karimn14/firware-reflow-oven-bluepill/heater_char/perbandingan grafik.png

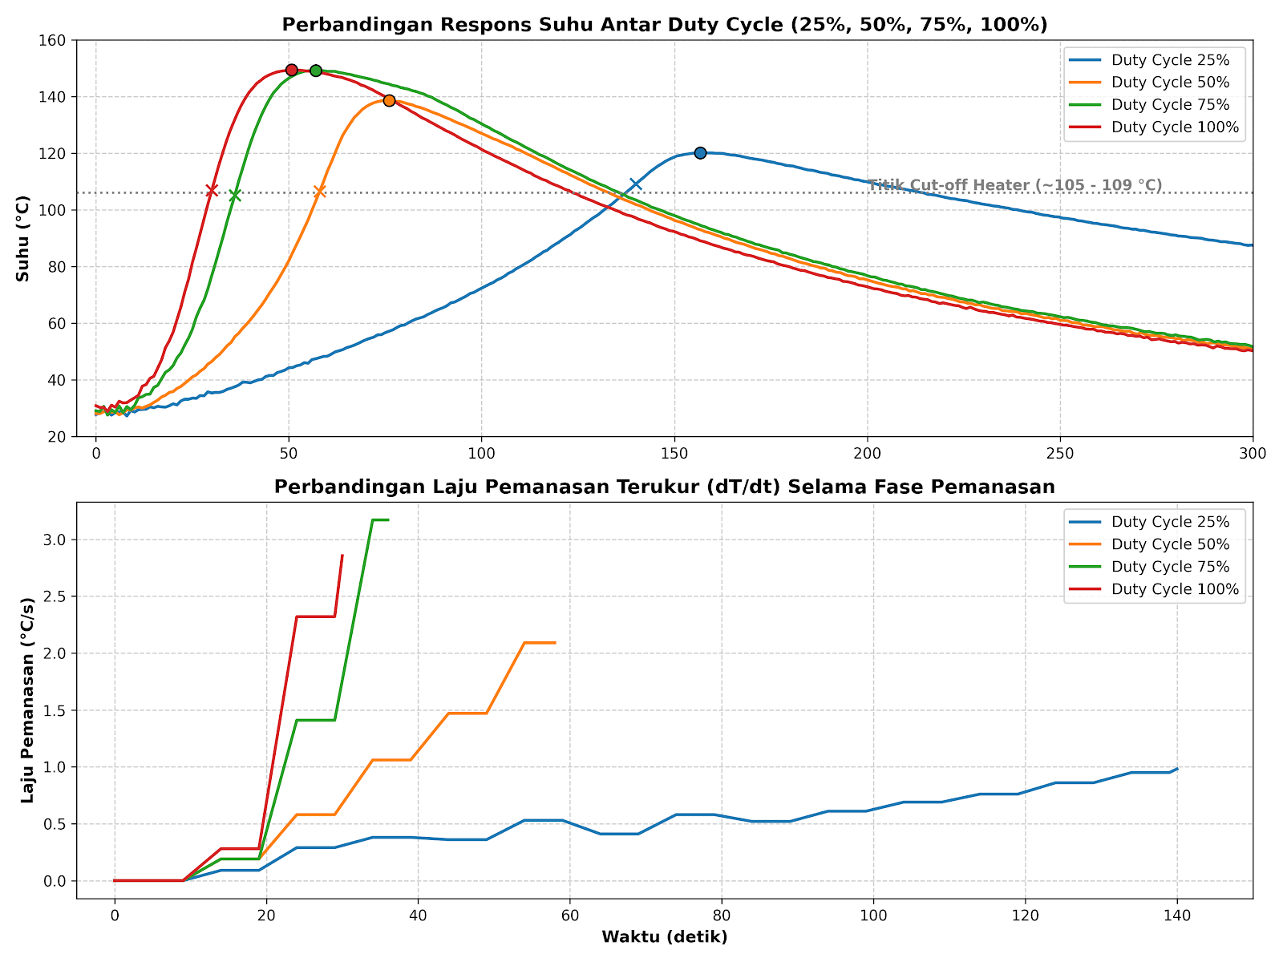
heater_char/perbandingan grafik.png
