karimn14/firware-reflow-oven-bluepill/heater_char/heater_individual_dc_characterization.png

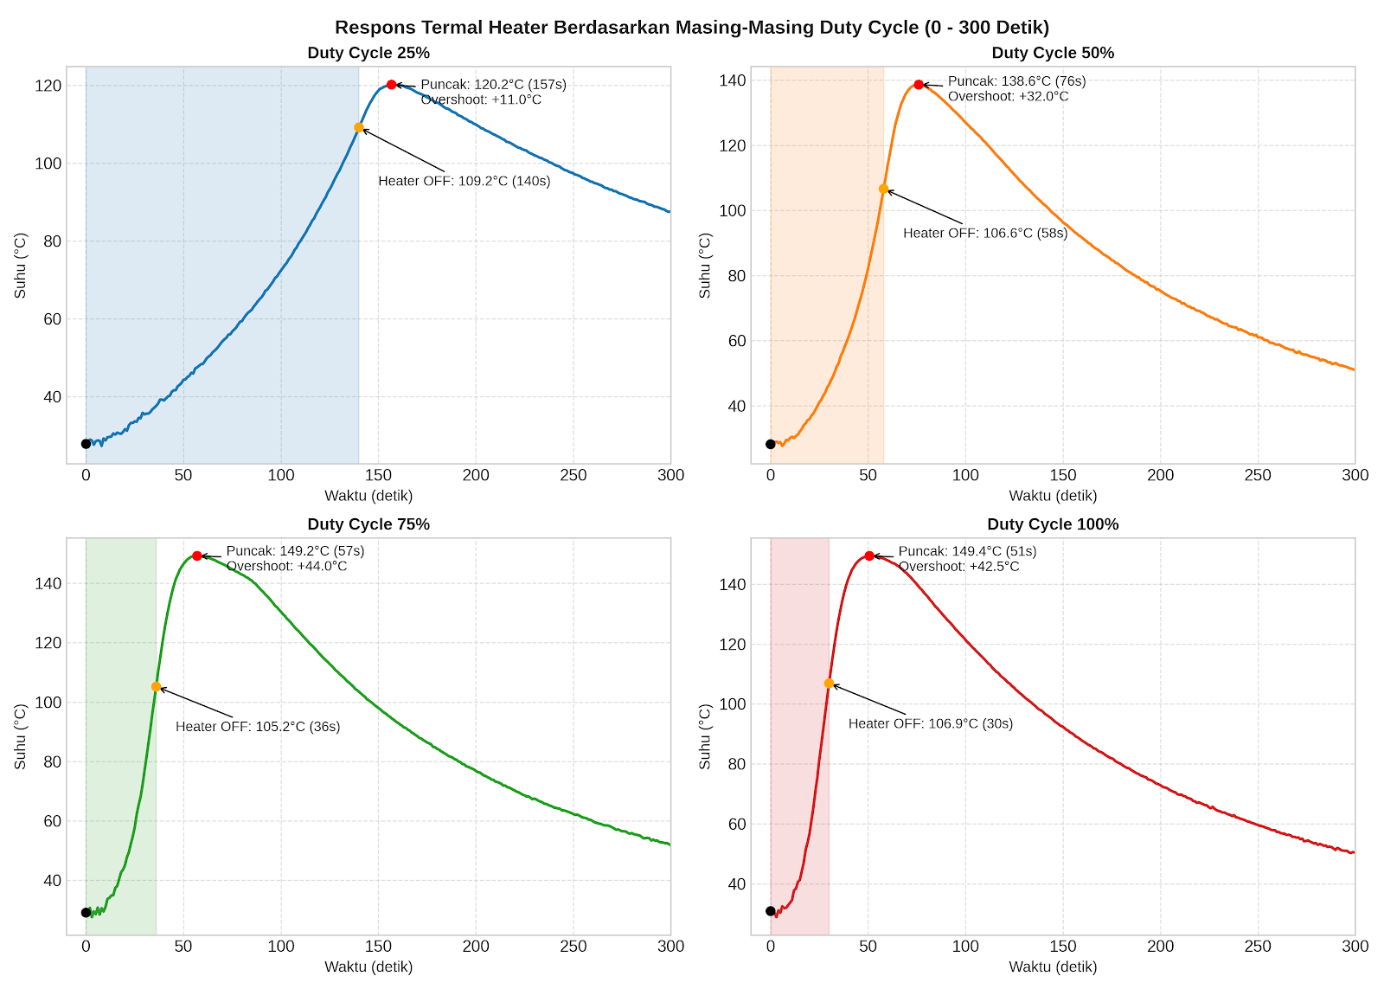
heater_char/heater_individual_dc_characterization.png
