karimn14/firware-reflow-oven-bluepill/Core/Inc/main.h

#define TERMISTOR_Pin GPIO_PIN_0
#define TERMISTOR_GPIO_Port GPIOA
#define CONVEYOR_SERVO_Pin GPIO_PIN_2
#define CONVEYOR_SERVO_GPIO_Port GPIOA
#define PWM_HEATER_Pin GPIO_PIN_6
#define PWM_HEATER_GPIO_Port GPIOA
#define PWM_FAN_Pin GPIO_PIN_7
#define PWM_FAN_GPIO_Port GPIOA
#define CONVEYOR_ENCODER_Pin GPIO_PIN_8
#define CONVEYOR_ENCODER_GPIO_Port GPIOA
#define CONVEYOR_IR_Pin GPIO_PIN_1
#define CONVEYOR_IR_GPIO_Port GPIOB
#define PWM_DC_MOTOR_Pin GPIO_PIN_8
#define PWM_DC_MOTOR_GPIO_Port GPIOB
#define BTN_A_Pin GPIO_PIN_12
#define BTN_A_GPIO_Port GPIOB
#define BTN_A_EXTI_IRQn EXTI15_10_IRQn
#define BTN_B_Pin GPIO_PIN_13
#define BTN_B_GPIO_Port GPIOB
#define BTN_B_EXTI_IRQn EXTI15_10_IRQn
#define BTN_C_Pin GPIO_PIN_14
#define BTN_C_GPIO_Port GPIOB
#define BTN_C_EXTI_IRQn EXTI15_10_IRQn
#define BTN_D_Pin GPIO_PIN_15
#define BTN_D_GPIO_Port GPIOB
#define BTN_D_EXTI_IRQn EXTI15_10_IRQn
#define OLED_SCL_Pin GPIO_PIN_6
#define OLED_SCL_GPIO_Port GPIOB
#define OLED_SDA_Pin GPIO_PIN_7
#define OLED_SDA_GPIO_Port GPIOB
