karimn14/firware-reflow-oven-bluepill/(commit log)

2026-09-19 setup bluepill cmake, stm32-hid-bootloader, kalibrasi termistor 100kOhm + 4.7k Resistor, PWM Untuk SSR dan plant hot plate, kendali suhu berbasis PID
2026-09-21 Penambahan README.md
    Penambahan Task Komunikasi USB CDC
    Fitur console:
    - Menampilkan prompt saat terminal dibuka.
    - Input command dengan echo, backspace, dan CR/LF.
    - Ring buffer RX 256 byte.
    - Panjang command maksimal 95 karakter.
    - Task FreeRTOS berprioritas rendah dengan stack statis 1 KiB.
    - Mekanisme reset menuju HID bootloader tetap berfungsi.
    Command tersedia:
    help
    ping
    info
    status
    echo <teks>
    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
    [cdc_console.c, cdc_console.h, hardware_test.c, hardware_test.h]
2026-09-21 Penambahan Task PCB Reflow Profile, dan suhu yang bisa diatur di tiap stage nya.
2026-09-21 program karakterisasi heater, dokumen hasil karakterisasi heater, minimizing RAM usage, automatic log through USB CDC
    [heater-char-100.log.csv, heater-char-25.log.csv, heater-char-50.log.csv, heater-char-75.log.csv]
2026-09-22 prosedur simulasi end to end conveyor heater dan servo, belum memasukan komunikasi usb cdc dengan raspberry pi untuk deteksi, driver diganti dengan ibt2, fan belum ter integrasi
2026-09-22 konfigurasi encoder dengan timer 1, dan pengaplikasian filter pada pembacaan encoder
2026-09-22 Switch the Raspberry Pi link to the agreed protocol ($DET/$RES)
    inspection.c now speaks the protocol in sunda_reflow_oven/docs/stm-pi-protocol.md,
    which the Pi station already implements:
    - $DET,id=N after a 300 ms settle, resent every 300 ms (max 3) until the Pi's $ACK
    - $RES,id=N,v=PASS|FAIL is acknowledged with $ACK; only the board under the camera counts
    - no verdict 3 s after the first $DET -> servo left (REJECT), $SORT carries why=TIMEOUT
    - $SORT when the servo is back at centre, $EVT on faults, $STAT every 500 ms, $HELLO on connect
    - the Pi heartbeat ($HB) drives VIS:OK/-- on the conveyor OLED page; it never blocks the cycle
    - checksums are required; every '$' line is handled silentl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
    [cdc_console.c, conveyor_app.h, conveyor_config.h, conveyor_sequencer.h, hardware_test.c, inspection.c, inspection.h, pi_protocol.c]
2026-09-22 PID tuning dan setup kipas 4 wire dengan PA7 dan TIM3
2026-09-22 Kirim duty fan melalui telemetri USB CDC
2026-09-23 oled menu and pcb reflow poc full, real pcb reflow e2e is locked until actual measurement is complete
2026-09-23 Add OLED servo test and move PWM output to PA2
2026-09-23 iwdg setup (multiplexing), laporan tiap task (prioritas, stack allocation, periode tiap task), penghapusan ServoTest yang redundant.
2026-09-23 task stack report, dan menu penambahan menu di diagnostik oled.
